copperheadhq/copperhead-555-oscillator/docs/DECISIONS.md

- 2026-11-10 [run 2026-11-10T13-39-13-392Z] SPEC sets VBUS range 4.75–5.25 V, a timing-cap tolerance of ≤5 %, ~10 % endpoint margin on the frequency range, high-Z load ≥1 kΩ‖≤150 pF, and R_A ≥ 1 kΩ (all ASSUMED). | why: The brief is silent on these values. They are the standard USB 2.0 and 555 practice that keep the 30 mA budget and the 10 kHz–1 MHz range achievable. | affects: docs/SPEC.md; timing network; ESD; output
- 2026-11-10 [run 2026-11-10T13-39-13-392Z] No openspec/specs/ seeded | why: No openspec/ capability workspace exists (only the change folder created by this proposal), so the stage instruction to seed it does not apply. | affects: openspec/
- 2026-11-10 [run 2026-11-10T13-39-13-392Z] Keep TPD1E10B06DYAR on VBUS, and document that its ≤10 V clamp exceeds the SN74LVC1G17's 6.5 V abs-max | why: Bench USB supply has ESD exposure only. The local 100 nF and 10 µF capacitors absorb the residual energy. Flagged in SPEC §8 for the schematic stage rather than silently claimed safe. | affects: VBUS ESD diode; U2 SN74LVC1G17; docs/SPEC.md
- 2026-11-10 [run 2026-11-10T13-41-05-012Z] Register R_A >= 1 kOhm as constraint timing.ra_min_ohm (ASSUMED) | why: SPEC §2 stated it as a budget, but no registry entry existed. A minimum R_A bounds the timing-network current at 1 MHz within the 30 mA supply budget. | affects: timing network R_A; docs/SPEC.md §2; .copperhead/constraints.json
- 2026-11-10 [run 2026-11-10T13-41-58-945Z] Patch docs/SPEC.md in place and do not rewrite it. Add registry keys timing.trimmer (100 kΩ 25-turn), timing.cap_nF (1 nF), board.mounting_holes (2× M3) and build.quantity (about 5). Seed openspec/specs/{power,oscillator,output,physical}/spec.md with Given/When/Then scenarios. | why: The existing SPEC already held every other budget. These four stated values had no registry key, and an openspec/ workspace now exists, so the capability specs apply. | affects: docs/SPEC.md §3 and §5; .copperhead/constraints.json; openspec/specs/
- 2026-11-10 [run 2026-11-10T16-25-05-768Z] Timing network: R_A = 1.00 kΩ 1 %, R_B = 120 Ω 1 % fixed in series with a 100 kΩ 3296W rheostat, C = 1 nF C0G. The ideal range is 7.2 kHz to 1.16 MHz. | why: R_A sits at the timing.ra_min_ohm floor to maximise f_max. The fixed R_B keeps a defined low phase at the trimmer end stop. The low end meets the ≤9 kHz margin across the trimmer's ±10 %. The top end margin is thin and is tracked as timing.trimmer_end_resistance_ohm. | affects: R3, R4, RV1, C4, U1; docs/SUBSYSTEMS.md
- 2026-11-10 [run 2026-11-10T16-25-05-768Z] Activity LED D3 is driven from BUF_OUT (U2 output, before the 33 Ω R5) through 2.0 kΩ. The power LED D2 is on +5V through 2.0 kΩ. | why: This keeps the LED two stages away from the timing node (timing.node_loading) and off U1's output. The ≈1.5 mA per LED keeps the total near 9.6 mA, against 30 mA. | affects: D2, D3, R6, R7, U2; nets BUF_OUT, +5V
- 2026-11-10 [run 2026-11-10T16-25-05-768Z] No MCU, no connectivity subsystem, no regulator, no battery and no range switch. USB D+ and D− carry no-connect flags. | why: The brief is a purely analog 555 oscillator powered from USB only, and power.regulator forbids a regulator or battery. Stating the absence prevents it from being read as an omission. | affects: docs/SUBSYSTEMS.md; J1
- 2026-11-10 [run 2026-11-10T16-30-05-732Z] Two timing ranges: C4 3.3 nF C0G (LO) and C6 330 pF C0G (HI), both ±5 %. R3 1.00 kΩ, R4 120 Ω and RV1 3296W 100 kΩ are kept. Worst case: LO 2.54–120.6 kHz, HI 25.4 kHz–1.206 MHz, overlap 4.7:1. | why: The worst-case R span per range is 52.5:1 with 1 % end resistance (47.5:1 after C tolerance). A 10:1 capacitor step gives about 5:1 overlap and ≥ 20 % top margin for the TLC555 delays. | affects: C4, C6, R3, R4, RV1; docs/SPEC.md §3; docs/SUBSYSTEMS.md
- 2026-11-10 [run 2026-11-10T16-30-05-732Z] SW1 is an SPDT top-side slide switch with its common on GND and its throws on the ground ends of C4/C6, so it switches the capacitor's ground return and not the TIMING node. | why: This keeps switch contacts and their trace length off the timing node (timing.node_loading). The unselected capacitor adds only about the switch off-capacitance, a few pF. | affects: SW1, C4, C6, net TIMING
- 2026-11-10 [run 2026-11-10T16-30-05-732Z] The silkscreen range labels are 'LO 10–100 kHz' and 'HI 100 kHz–1 MHz'. The current-budget upper bound is now ≈ 14.7 mA. | why: Each label lies inside its position's worst-case range. The current rises because the ideal HI end stop is up to ≈ 3.6 MHz, which raises the capacitor-charging and buffer C·V·f terms. That is still under 30 mA. | affects: docs/SPEC.md §2, §5; docs/SUBSYSTEMS.md current budget, Mechanical
- 2026-11-10 [run 2026-11-10T16-36-35-457Z] J2 BNC is the Amphenol RF B6252HB-NPP3G-50 right-angle THT, substituted for 31-5536-RFX. | why: No 31-5536 footprint is installed. The installed 031-6575 footprint has pads 3 and 4 with no pin on any installed coax symbol. The B6252HB keeps the brief's right-angle, board-edge, through-hole intent and maps 1:1 onto Connector:Conn_Coaxial. The connector's 50 Ω rating is not a drive claim (output.load). | affects: J2; docs/parts.intent.json substitutions; docs/SUBSYSTEMS.md; docs/SPEC.md §1, §8
- 2026-11-10 [run 2026-11-10T16-36-35-457Z] SW1 range switch is the C&K JS102011SAQN, a top-actuated SPDT SMD slide switch. | why: It meets timing.range_switch (top side, SPDT) and env.temperature_C (−40 to +85 °C). It carries only capacitor return current, well inside its 300 mA at 6 VDC rating. Its symbol (Switch:SW_SPDT) and footprint are installed. | affects: SW1; docs/SUBSYSTEMS.md Timer core; docs/SPEC.md §8
- 2026-11-10 [run 2026-11-10T16-36-35-457Z] Passive part choices:
- C4 GRM1885C1H332JA01D and C6 GRM1885C1H331JA01D, both C0G ±5 %.
- Yageo RC0603FR 1 % resistors.
- Samsung X7R for bypass and X5R for the 10 µF bulk.
- Würth 150060GS75000 green 0603 LEDs, 2.0 kΩ.
- D1 TPD1E10B06DYAR drawn as Device:D_TVS on SOD-523. | why: These meet timing.cap_dielectric, timing.resistor_tolerance_pct and env.temperature_C. Quiescent and leakage currents are U1 ≈ 170 µA, U2 ≤ 10 µA and D1 ≤ 1 µA, so the ≈ 14.7 mA bound against 30 mA is unchanged. TPD1E10B06 has no library symbol, and as a bidirectional single diode the generic TVS symbol is exact. | affects: C1–C6, R1–R7, D1–D3; docs/BOM.md
- 2026-11-10 [run 2026-11-10T16-39-40-062Z] SW1 (Switch:SW_SPDT) wiring: pin 2 (B, common) to GND, pin 1 (A) to CAP_LO (C4.2), pin 3 (C) to CAP_HI (C6.2). | why: This puts the switch in the capacitor ground return, so no switch contact sits on TIMING (timing.range_switch, timing.node_loading). | affects: SW1, C4, C6; nets CAP_LO, CAP_HI, GND; docs/PINOUT.md
- 2026-11-10 [run 2026-11-10T16-39-40-062Z] RV1 is wired as a rheostat: pin 1 and wiper pin 2 on RB_TRIM (from R4), pin 3 on TIMING. | why: A shorted wiper means a wiper lift-off cannot open-circuit R_B. The range then falls back to the full track, not an uncontrolled state. | affects: RV1, R4; nets RB_TRIM, TIMING
- 2026-11-10 [run 2026-11-10T16-39-40-062Z] J1's shell (SH) is tied directly to GND, and U1 ~RST is tied to +5V. | why: This is a bench board with no enclosure and no shield drain to manage. Tying ~RST high keeps the timer always running, per SUBSYSTEMS. | affects: J1, U1; nets GND, +5V
- 2026-11-10 [run 2026-11-10T16-39-40-062Z] Accept the verify_symbols 'wrong-library' findings for the power symbols that draft_schematic synthesizes (copperhead_power:+5V/GND/PWR_FLAG). Do not patch the sheet. | why: The engine generates these symbols, and edit_file is refused on the drafted sheet. Pins and names match power:*, and ERC is clean. They are flagged in CHANGELOG so that a later engine fix can remap them to power:*. | affects: 5-v-variable-frequency-555-oscillator.kicad_sch power symbols
- 2026-11-10 [run 2026-11-10T16-41-22-515Z] Layout draft: 60 × 35 mm outline, J1 on the left edge and J2 BNC on the right edge (both rotated 270°), U1 centred with the timing cluster (C4, C6, R3, R4, RV1, TP3) on its left and SW1 above C4/C6. TIMING is routed as one ≈ 8 mm F.Cu lane at y = 117.365, on the side away from U2 and the outputs. | why: This follows the signal flow J1 → U1 → U2 → J2, keeps TIMING short and away from BUF_OUT/OUT (timing.node_loading), and keeps SW1 only in the capacitor ground return (timing.range_switch). | affects: all footprints; nets TIMING, DIS, CAP_LO, CAP_HI, +5V; docs/LAYOUT.md
- 2026-11-10 [run 2026-11-10T16-41-22-515Z] Leave GND (no pour yet), most of +5V and the signal nets RAW, BUF_OUT, OUT, CONT, CC1, CC2, RB_TRIM and the LED nets as ratsnest: 46 connections, down from 56. The 4 J1 hole_clearance DRC findings are accepted as library-footprint geometry. | why: The stage asks for power and the short critical nets only. The finding is inside the GCT USB4105 footprint and cannot be fixed without editing the footprint, which the stage gate forbids. Both are listed in docs/LAYOUT.md Draft quality for follow-up. | affects: 5-v-variable-frequency-555-oscillator.kicad_pcb; J1; docs/LAYOUT.md
- 2026-11-10 [run 2026-11-10T17-27-11-140Z] Route the TIMING tie U1.6 → U1.2 as one straight F.Cu segment under U1 (≈ 5.1 mm). Keep the F.Cu GND pour off TIMING with a copperpour-only rule area over the lane, the tie and the TP3 stub. The B.Cu plane stays solid under it. | why: This is the shortest TIMING path. The pour keepout avoids adding top-layer capacitance to TIMING (timing.node_loading), while the B.Cu plane gives the continuous ground required by SPEC §5. | affects: net TIMING; U1; zones TIMING_F_pour_keepout, GND_F_pour, GND_B_plane
- 2026-11-10 [run 2026-11-10T17-27-11-140Z] GND is connected by explicit tracks: an F.Cu stub and via at every SMD GND pad, onto a B.Cu track network (spine x = 102.5, buses y = 103 and y = 129.8, riser x = 152.08). This is in addition to the full-board B.Cu and F.Cu GND zones. All +5V and signal copper is on F.Cu. | why: kicad-cli DRC here does not refill zones, so connectivity must not depend on the pour. Keeping all non-GND copper off B.Cu leaves the plane uncut under the oscillator and the output path. | affects: net GND, +5V; B.Cu; docs/LAYOUT.md
- 2026-11-10 [run 2026-11-10T17-27-11-140Z] Keep the 15 pure stitching vias even though DRC reports them as via_dangling warnings while the F.Cu zone is unfilled. Require Fill All Zones in KiCad before any fab export. | why: The person asked for stitching vias. The warnings come from the unfilled zone, not from the geometry, and they are warnings, not errors. Removing the vias to silence DRC would drop a requested feature, and unfilled zones would ship gerbers without any pour. | affects: GND stitching vias; docs/LAYOUT.md Draft quality
- 2026-11-10 [run 2026-11-10T17-27-11-140Z] Supersedes the earlier 'keep the 15 stitching vias' decision. Removed the 16 pure perimeter stitching vias and their B.Cu drops. Inter-layer GND stitching for now comes from the 13 GND pad vias. Perimeter stitching is deferred to a KiCad session after Fill All Zones. | why: With the F.Cu pour unfilled in the saved file (no tool here can fill zones), the perimeter vias had no F.Cu copper and failed DRC. The pad vias already join both layers across the board, and stitching placed against a filled pour can be verified by DRC. | affects: net GND stitching vias; docs/LAYOUT.md Draft quality; docs/CHANGELOG.md
- 2026-11-10 [run 2026-11-10T18-09-56-579Z] Set J1 (USB4105) GND pads A1, A12, B1, B12 to solid zone connection (zone_connect 2) on the board instance; the library footprint is unchanged. | why: With zones filled, DRC (--refill-zones) reported starved_thermal on these four pads against GND_F_pour: the fine pitch leaves too few thermal spokes. Solid connection is standard for USB-C GND pins and strengthens the SPEC §5 ground return. Reflow assembly by the fab is unaffected. | affects: J1 pads A1/A12/B1/B12; net GND; zones GND_F_pour, GND_B_plane; docs/LAYOUT.md
- 2026-11-10 [run 2026-11-10T18-15-04-031Z] SW1 silkscreen: 'LO 10–100 kHz' to the right of SW1 (pad 1, /CAP_LO, x ≈ 125.6) and 'HI 100 kHz–1 MHz' to the left (pad 3, CAP_HI, x ≈ 120.6). | why: The JS102011SAQN actuator connects common pad 2 to the terminal on its own side (C&K sheet I-52, research/parts/range-switch.md), so the slider position names the range. Confirm with a meter on the first board. | affects: SW1; silkscreen; timing.range_switch; docs/LAYOUT.md
- 2026-11-10 [run 2026-11-10T18-15-04-031Z] Label RV1 'CW = f ↑'. Label J2 'OUT (Hi-Z)', label J3's pins 'SIG' and 'GND' instead of 'OUT (Hi-Z)', and label TP5 'OUT'. No '50 Ω' text anywhere. | why: Clockwise moves the 3296 wiper toward pin 3 (TIMING), which lowers R_B and raises f. The person chose pin labels for J3 and OUT for TP5 (net OUT after R5, SPEC §4). Writing '50 Ω' is forbidden by output.load and SPEC §7. | affects: RV1, J2, J3, TP5; silkscreen; docs/SUBSYSTEMS.md; docs/LAYOUT.md
- 2026-11-10 [run 2026-11-10T19-29-22-474Z] Waive the 4 DRC hole_clearance findings inside J1 (GCT USB4105-GF-A): pads A1, A12, B1, B12 (GND) are 0.1944 mm from the footprint's own NPTH locating holes, against the 0.25 mm board rule. Keep the stock footprint unmodified. | why: Three grounds: (1) it is GCT's recommended land pattern in the stock KiCad footprint; (2) the copper is J1's own GND pads, so a drill nick cannot short anything; (3) JLCPCB's capabilities page (read 2026-11-10) gives a 0.2 mm NPTH-to-track minimum, so this is about 6 µm (5.6 µm) under. If fab DFM flags it, answer with this waiver. | affects: J1 pads A1/A12/B1/B12; net GND; DRC report; docs/LAYOUT.md Draft quality
- 2026-11-10 [run 2026-11-10T19-30-41-535Z] outputs/BOM.csv groups parts by MPN, with columns refdes, MPN and qty. It leaves out TP1–TP5 and H1–H2 (noPart: bare pads and holes) and carries no UNVERIFIED marker. The UNVERIFIED status stays in docs/BOM.md. | why: An ordering file should list only purchasable lines, and it is generated from docs/BOM.md so it cannot drift from it. MPN stock and lifecycle must still be checked before ordering (SPEC §8). | affects: outputs/BOM.csv; docs/BOM.md; all purchased parts
- 2026-11-10 [run 2026-11-10T19-32-24-380Z] Firmware stage: write firmware/README.md as '# No firmware'. Generate no HAL, pins.h or driver stubs. Flag explicitly that 74xGxx (U2 SN74LVC1G17) and copperhead_power (+5V/GND/PWR_FLAG) are outside the stage's non-programmable allowlist. | why: There is no MCU and no programming path (SPEC §1/§2, SUBSYSTEMS 'Not present'). U2 is fixed-function logic with no registers. copperhead_power is the engine's stand-in for power:*. Inventing source would describe hardware that does not exist. The allowlist gap belongs in the gate, not the design. | affects: firmware/README.md; U2; power symbols; docs/CHANGELOG.md
- 2026-11-10 [run 2026-11-10T19-34-17-558Z] Bring-up uses a 30 mA current limit on the 5 V supply, and range-end frequencies are measured at TP5/J2 with TP3 unprobed. The ngspice range-end check, BOM verification with LCSC numbers, and a CPL file are pre-order gates in docs/DEVPLAN.md. | why: 30 mA is the power.supply_current_mA budget, and the expected draw is ≤ 14.7 mA, so hitting the limit means a fault. A probe on TIMING shifts HI by ≈ 3–4.5 %. A JLCPCB PCBA order needs LCSC numbers and a CPL file, and outputs/ has neither. The HI top margin against TLC555 delays is unverified (SPEC §8). | affects: docs/DEVPLAN.md; outputs/jlcpcb-bom.csv; outputs CPL; TP3, TP5, J2
- 2026-11-10 [run 2026-11-10T19-36-24-548Z] State the existing registry key firmware.programmable_devices (max 0) in docs/SPEC.md §1 and on the MCU line of docs/SUBSYSTEMS.md 'Not present'. | why: The sync verifier flagged a dual-write gap: the key was in the registry but in no doc. Its source names these sections. The constraint itself is unchanged. | affects: docs/SPEC.md §1; docs/SUBSYSTEMS.md; firmware/README.md
- 2026-11-10 [run 2026-11-10T22-16-06-792Z] SW1 3D model is ${KIPRJMOD}/lib/ck_switches.3dshapes/SW-SMD_JS102011SAQN.step (EasyEDA, LCSC C221660), with offset (0, -0.475, 0.475) mm and rotation (0, 0, 0). Only the model block changed; there is no footprint, copper, placement or net change. | why: KiCad 10 does not ship SW_SPDT_CK_JS102011SAQN.step. The offset comes from the STEP coordinates:
- The locating pegs centre on model y = 0.475; moving them -0.475 puts them on the footprint NPTH at y = 0.
- The seating plane is at model z = -0.475; +0.475 puts it on the board surface.
- The terminals at x = -2.5/0/+2.5 land inside pads 1/2/3, spanning footprint y -1.75 to -3.7 within the pad's -1.5 to -4.0.
- The body spans ±1.75 against the Fab outline's ±1.8.
- The actuator ends at footprint y +3.75, on the courtyard-bulge side.
The EasyEDA model's +y equals the footprint's -y, so no rotation is needed. The check is numerical; no visual 3D render was inspected here. | affects: SW1 model; outputs/board.step; outputs renders; docs/LAYOUT.md
- 2026-11-10 [run 2026-11-10T22-18-55-021Z] Supersedes 'GND is connected by explicit tracks'. Removed the 24-segment B.Cu GND track network. GND connectivity is now the filled GND_B_plane and GND_F_pour zones plus the 13 pad vias and the F.Cu GND stubs. | why: The person asked for it after review. The tracks existed only because the zones could not be filled at routing time. With the zones filled (commit 23aaf9f) the tracks lay inside the plane and were redundant. DRC on the saved fill shows 0 unconnected and no via_dangling. The zone refill and save, and the --refill-zones DRC, could not be run with this toolchain and remain open before fab. | affects: net GND; B.Cu; zones GND_B_plane/GND_F_pour; J2/J3 GND pads; docs/LAYOUT.md; docs/DEVPLAN.md task 6
- 2026-11-10 [run 2026-11-10T22-27-46-251Z] Supersedes 'SW1 range switch is the C&K JS102011SAQN'. SW1 is the C&K JS102011SCQN (LCSC C221661), a top-slide SPDT SMD switch on the project footprint ck_switches:SW_SPDT_CK_JS102011SCQN (sheet I-53 pads). It stays at (123.1, 107), 180°, with nets unchanged. The CAP traces are extended to the new pads at y 104.5, and the GND stub and via are kept. | why: The brief and research/parts/range-switch.md require the slider to be moved from above (person's decision 2026-11-10). The old position leaves ≥ 3 mm of clear board around the body, with no tall part nearby. Keeping the rotation keeps pad 1 (LO) on the right, so the silkscreen sides are unchanged. | affects: SW1; nets /CAP_LO, CAP_HI, GND; fp-lib-table; docs/BOM.md; docs/LAYOUT.md; docs/SPEC.md §8; docs/SUBSYSTEMS.md
- 2026-11-10 [run 2026-11-10T22-27-46-251Z] SW1 3D model is SW-SMD_JS102011SCQN.step with offset (0, +1.475, +0.625) mm and rotation (0, 0, 0). The LO and HI labels move to y 104.5, level with pads 1 and 3. The saved GND_F_pour fill was hand-patched around the new pads. | why: The STEP body centre is at model y −1.475 and the lead bottoms are at z −0.625, so the offset centres the body and puts the leads inside pads 1/2/3 (checked numerically). Sheet I-53: the slider connects the common to the terminal on its own side, so the pad-1 end is LO. The fill patch was needed because no tool here can refill zones; a refill before fab is still required. | affects: SW1 model; silkscreen; zone GND_F_pour; docs/LAYOUT.md; docs/DEVPLAN.md task 6
- 2026-11-10 [run 2026-11-10T22-44-43-338Z] F.Cu routing rule: 45° chamfers at track bends and no acute angles; turns at pad centres are allowed. Applied to corners #4–#11, #13, #14 and #16, and to the +5V tee near R2. The collinear chamfer pairs on /CAP_LO and CAP_HI each become a single diagonal. The saved GND_F_pour fill was cut back by hand along the new diagonals. | why: The person asked for this (research/layout/right-angle-bends/right-angle-bends.pdf). Pad copper covers a corner at a pad centre, so those turns stay. The fill had to be patched because no tool here can refill zones and the old fill overlapped the diagonals. The cuts only remove copper, so they are conservative. A real refill with --refill-zones is still required before fab. | affects: nets +5V, /CAP_LO, CAP_HI, /CC2, /DIS, RB_TRIM; zone GND_F_pour; docs/LAYOUT.md; docs/DEVPLAN.md task 6
- 2026-11-11 [run 2026-11-11T06-33-49-150Z] Added 5 local GND stitching vias (0.6/0.3 mm) at (137.2,121), (140.3,120.5), (143.9,116.8), (143.9,120.4) and (122.8,124.3). These replace the perimeter-fence to-do; no fence is placed. No via went into the CAP_HI/CAP_LO strip, which already has the SW1 via at its root and runs beside TIMING. | why: The vias give the output edges (U2 → R5 → J2/J3) a short layer-to-layer return. They also ground the three F.Cu pour fingers or pockets that joined at one end only and had no via, per the person's request and SPEC §5. Keeping away from TIMING protects timing.node_loading. Each via sits in saved fill on both layers, so DRC shows no via_dangling without a refill. The refill itself stays DEVPLAN task 6. | affects: net GND; zones GND_F_pour, GND_B_plane; U2, R5, R7, J2, J3, RV1 area; docs/LAYOUT.md; docs/DEVPLAN.md tasks 6–7, risk 10
- 2026-11-11 [run 2026-11-11T06-40-42-448Z] Supersedes the 'one straight F.Cu segment' part of the TIMING-tie decision. U1.6 → U1.2 is now straight (126.525, 117.365)–(128.365, 117.365), then 45° to (129.635, 118.635), then straight to (131.475, 118.635). All three are 0.25 mm F.Cu on TIMING, inside the unchanged TIMING_F_pour_keepout. | why: The person asked for it (2026-11-11) so the tie follows the F.Cu 45° bend rule. The extra ≈ 0.36 mm adds negligible capacitance to TIMING (timing.node_loading). The path clears U1.7/U1.3 by ≈ 0.85 mm, and DRC is clean. The zone refill cannot be run here and stays DEVPLAN task 6. | affects: net TIMING; U1 pins 2/6; zone TIMING_F_pour_keepout; docs/LAYOUT.md; docs/DEVPLAN.md task 6
- 2026-11-11 [run 2026-11-11T06-45-37-422Z] The saved GND fill from commit c6fb79e (kicad-cli pcb drc --refill-zones --save-board, 2026-11-11) is the current fill of record. It supersedes the hand-patched fills from remove-bcu-gnd-track-network, sw1-top-actuated-js102011scqn and fcu-chamfer-bends-5v-tee, and the 'refill before fab' caveats in the earlier decisions. DEVPLAN task 6 is done, and risk 9 and the task 7 via_dangling check are closed. outputs/ was re-exported from this board, and task 8 is marked done only for those files. | why: The refill moved no object, and on the saved fill DRC gives 0 unconnected, only the 4 waived J1 hole_clearance findings, no starved_thermal and no via_dangling. run_drc in this run confirms 0 unconnected and the 4 waived findings. jlcpcb-bom.csv and the CPL file do not exist yet, so they stay with tasks 2 and 3. | affects: zones GND_F_pour, GND_B_plane; J1, J2, J3 GND pads; 5 stitching vias; outputs/*; docs/DEVPLAN.md tasks 6–8, risk 9; docs/LAYOUT.md
- 2026-11-11 [run 2026-11-11T06-48-37-150Z] Move the F.SilkS Reference fields of J1, SW1, TP3, C6, C4, C3, R4, R3 and J2, and the 'probe shifts f' and 'TIMING' board texts, to the person's verified positions. TP3's refdes is right-justified left of its pad. C4/C6 go above their parts, R3/R4 go below theirs (vertical), and J2's goes inside its body outline. | why: A glyph-outline analysis found labels ≤ 0.15 mm from pad mask openings or touching each other, which a fab may clip and which makes refdes ambiguous during hand assembly. The person's scratch-copy check shows ≥ 0.15 mm everywhere and DRC unchanged. No copper or placement moved. | affects: J1, SW1, TP3, C3, C4, C6, R3, R4, J2 silkscreen; gr_text 'TIMING', 'probe shifts f'; docs/LAYOUT.md Silkscreen labels
- 2026-11-11 [run 2026-11-11T06-55-02-278Z] F.SilkS board text 'probe shifts f' at (118.4, 110.6) now reads 'probe shifts freq'. Anchor, right justification, 0.8 mm size and 0.15 mm stroke are unchanged, so the text grows about 2 mm to the left. | why: 'f' is cryptic at the bench. The label warns that a probe on TP3 shifts the oscillator frequency (timing.node_loading; DEVPLAN TP3 row). It stays on its own baseline above 'TIMING', with the same gap, in a band (y ≈ 110.2–111.0) that holds no pad, refdes or other label: D1, R1 and the J1 pads are at y ≥ 112.6. DRC shows no silkscreen finding. Person's request, 2026-11-11. | affects: gr_text 'probe shifts freq'; TP3; docs/LAYOUT.md, docs/BOM.md (via parts.intent.json), docs/PINOUT.md, docs/DEVPLAN.md, docs/SUBSYSTEMS.md
- 2026-11-11 [run 2026-11-11T06-54-09-369Z] J2 (B6252HB BNC) GND pads (all three pad "2": two 3.5 × 7.0 mm lugs, one 1.6 × 2.5 mm pin) get a board-instance pad override thermal_bridge_width 0.5 mm. Thermal relief is kept, the thermal gap stays 0.3 mm, the zones' own thermal_bridge_width stays 0.3 mm, and pad 1 (OUT) and the library footprint are untouched. | why: The BNC is the most-plugged connector, so wider spokes make its ground connection to both GND pours more robust (SPEC §5), while relief is kept for hand soldering (BRIEF). A pad-level override limits the change to J2. DRC (no refill) is clean. The refill and the --refill-zones check could not be run here and are DEVPLAN task 9. | affects: J2 pads 2; net GND; zones GND_F_pour, GND_B_plane; docs/LAYOUT.md; docs/DEVPLAN.md task 9; outputs/ gerbers
- 2026-11-11 [run 2026-11-11T10-48-21-889Z] The copperhead identity block is B.SilkS board graphics, all text (justify mirror). The mark (ring r 0.693 mm and four ticks to r 1.353 mm, 0.30 mm stroke, 3.0 mm across, SVG scaled 0.132) is at (141.5, 102.3). Beside it is the 1.0 mm `copperhead` wordmark at (135, 102.3), followed by 0.8 mm lines `555 variable oscillator` (136, 104.3), `5 V · 10 kHz–1 MHz · rev A` (136, 105.7) and `2026-11` (136, 107.1). | why: Per BRIEF Design constraints (2026-11-11). The strip x 127–146, y 100.8–107.6 has no back-side pad, via or hole, and is far from J1, J2, J3, RV1, H1 and H2. Mirroring puts the reader's left at board +x, so the mark sits at higher x than the wordmark. DRC shows no silkscreen findings. Front silk and copper are untouched. | affects: B.SilkS; docs/LAYOUT.md Bottom identity block; docs/DEVPLAN.md task 9 (re-export)
- 2026-11-11 [run 2026-11-11T11-17-15-630Z] Supersedes the B.SilkS identity-block decision. The copperhead identity block is on F.SilkS, not mirrored: mark at (121.5, 128.3), `copperhead` 1.0 mm left-justified at (123.6, 128.3), then `555 variable oscillator`, `5 V · 10 kHz–1 MHz · rev A` and `2026-11` at 0.8 mm centred on x 129, y 130.9 / 132.2 / 133.5. All 9 B.SilkS items were removed; B.SilkS is empty. | why: BRIEF Design constraints (person's decision 2026-11-11) and the area the person pointed at in the viewer. The strip below RV1/U1/TP4, between D2/R6 and D3/J3, holds no pad, test point, via or hole. The board's 0.8 mm silk text minimum (DRC text_height) rules out the 0.7 mm shrink, and 0.8 mm fits. DRC shows no silkscreen findings. | affects: F.SilkS, B.SilkS; docs/LAYOUT.md Front identity block; docs/DEVPLAN.md task 9 (re-export)
- 2026-11-11 [run 2026-11-11T15-50-11-246Z] Supersedes the centred-text and date parts of the F.SilkS identity-block decision. The '2026-11' line is deleted. '555 variable oscillator' is at (120.0, 130.7) and '5 V · 10 kHz–1 MHz · rev A' is at (120.0, 132.0), both left-justified at 0.8 mm / 0.15 mm. The mark (121.5, 128.3) and the wordmark (123.6, 128.3) are unchanged. | why: BRIEF Design constraints (person's decision 2026-11-11): no date, and lines left-aligned to the mark's left edge (left tick end 120.147 minus half its 0.3 mm stroke ≈ 120.0). Moving the lines up 0.2 mm spaces them evenly under the wordmark, 0.35 mm below the mark's lower tick, and 2.6 mm from the bottom edge. DRC shows no silkscreen or text_height findings. | affects: F.SilkS identity block; docs/LAYOUT.md Front identity block; docs/DEVPLAN.md task 9
- 2026-11-11 [run 2026-11-11T17-11-19-766Z] F.SilkS copperhead identity block translated rigidly by the full requested (+2.0, +1.0) mm: mark centre (123.5, 129.3), 'copperhead' (125.6, 129.3), '555 variable oscillator' (122.0, 131.7), '5 V · 10 kHz–1 MHz · rev A' (122.0, 133.0). Sizes, strokes, justification and left alignment unchanged; no offset reduction needed. | why: Person's review request ('a bit down and to the right'). The rating line's bottom is still ≈ 1.6 mm from the edge, and the block stays clear of J3, D3, H2, its label and the GND via at (138.7, 127). DRC shows no silk_over_copper, silk_overlap, silk_edge_clearance or text_height finding. | affects: F.SilkS identity block; docs/LAYOUT.md Front identity block; docs/DEVPLAN.md task 9 (re-export)
