copperheadhq/copperhead-555-oscillator/images/board-back.png

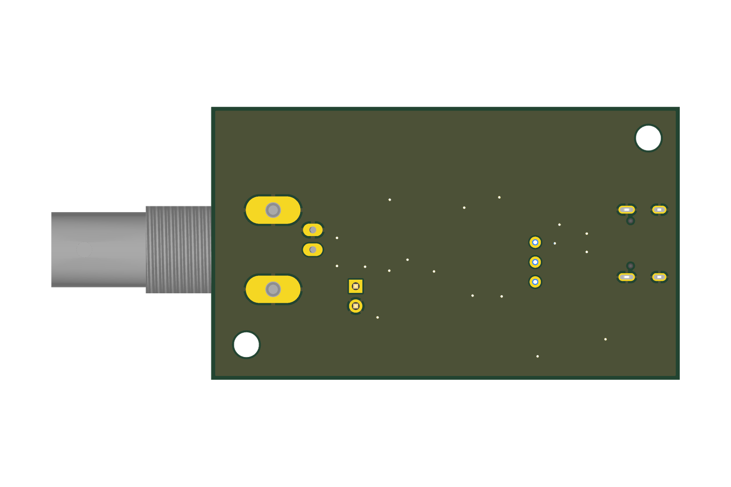
images/board-back.png
