copperheadhq/copperhead-555-oscillator/3d/555-oscillator-board-only.stl

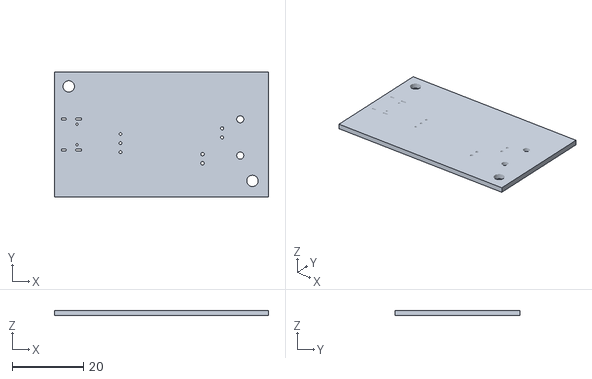
[picture p7: CAD file, 2026-11-11]
3d/555-oscillator-board-only.stl
60.0 x 35.0 x 1.51
