copperheadhq/copperhead-555-oscillator/3d/555-oscillator-mechanical.step

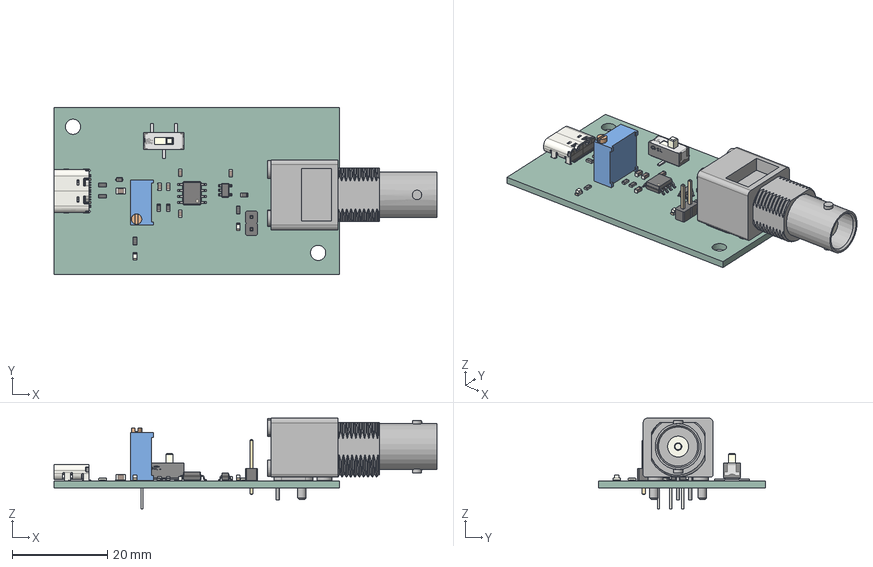
[picture p9: CAD file, 2026-11-11]
3d/555-oscillator-mechanical.step
80.5 x 35.0 x 19.1 mm
SW-SMD_JS102011SCQN
LED_0603_1608Metric x 2
PinHeader_1x02_P254mm_Vertical
C_0603_1608Metric x 5
BNC_Amphenol_B6252HB-NPP3G-50_Horizontal
R_0603_1608Metric x 7
USB_C_Receptacle_16P_TopMnt_Horizontal_GCT_USB4105-xx-A
C_0805_2012Metric
SOT-23-5
Potentiometer_Bourns_3296W_Vertical
D_SOD_523
SOIC-8_3.9x4.9mm_P1.27mm
5-v-variable-frequency-555-oscillator_PCB
