copperheadhq/copperhead-555-oscillator/(list of files, cad)

Other CAD files:
3d/555-oscillator.stl
