copperheadhq/copperhead-555-oscillator/docs/schematic.pdf

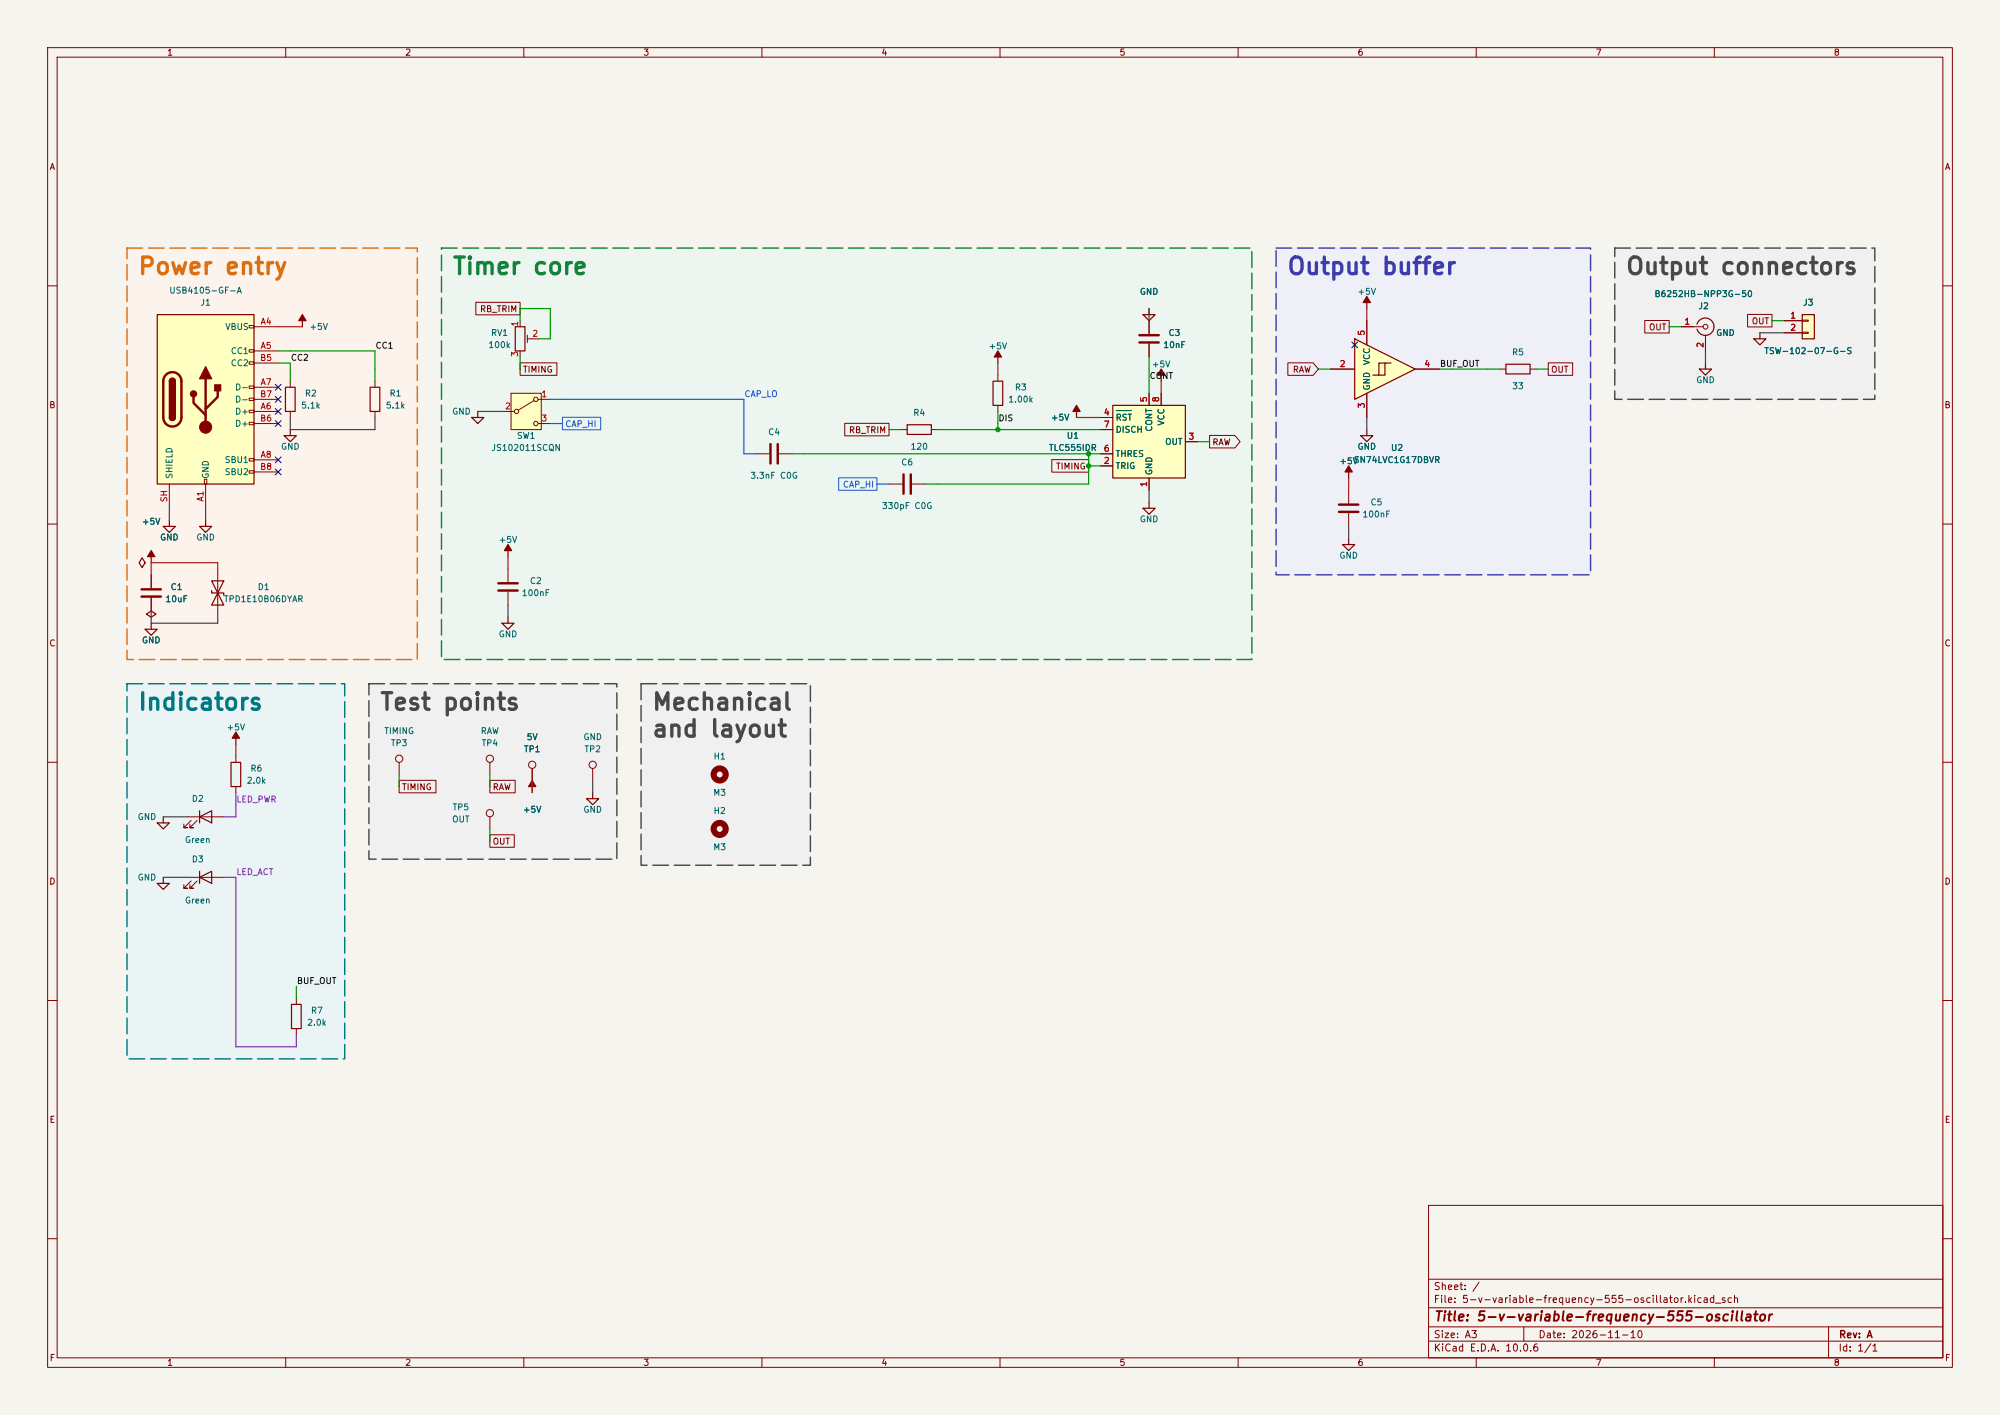
[picture p10: page 1]

Sheet: /
File: 5-v-variable-frequency-555-oscillator.kicad_sch
Title: 5-v-variable-frequency-555-oscillator

Size: A3 | Rev: A | F Date: 2026-11-10
KiCad E.D.A. 10.0.6 | Id: 1/1
