copperheadhq/copperhead-555-oscillator/hardware/5-v-variable-frequency-555-oscillator.kicad_pcb

## KiCad design hardware/5-v-variable-frequency-555-oscillator.kicad_pcb (2026-11-11)

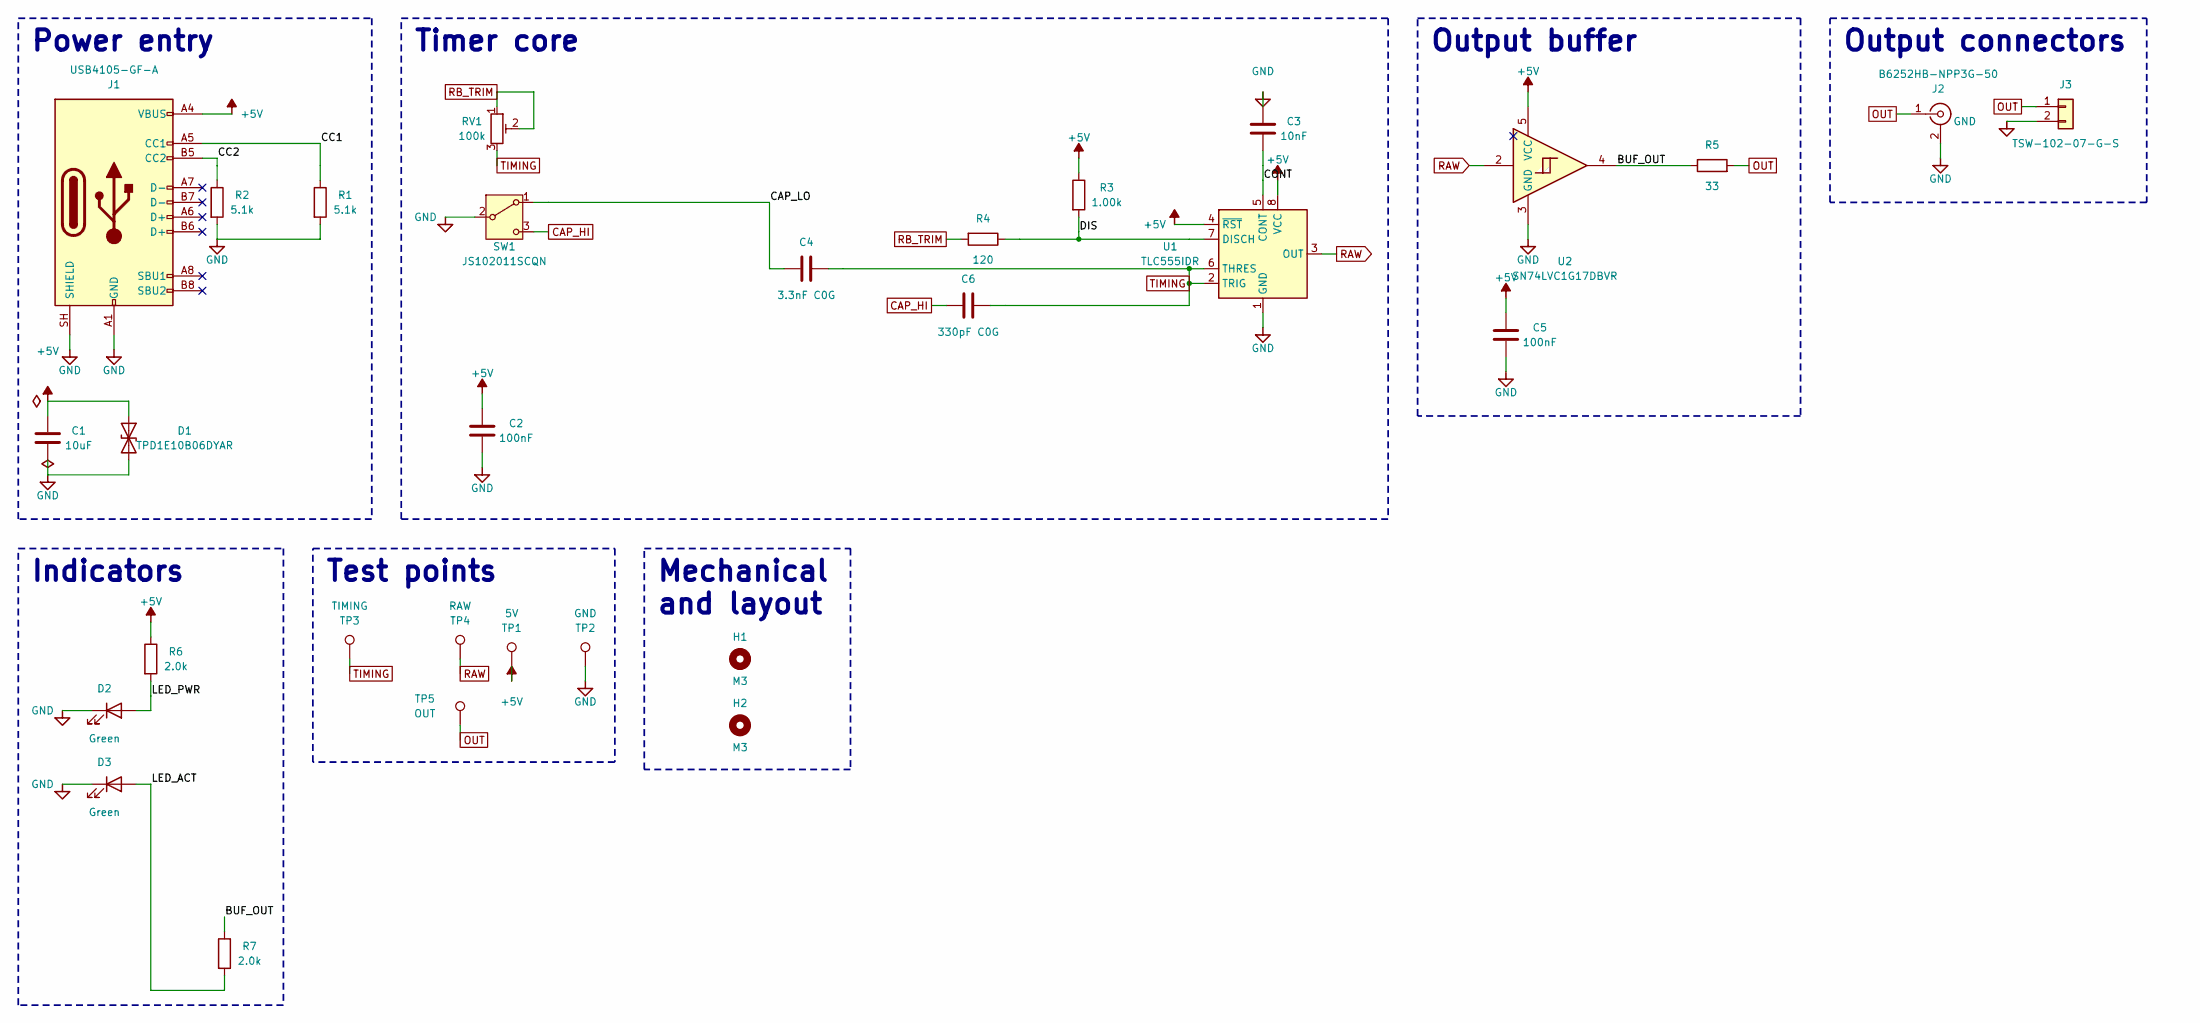
[picture p11: schematic 5-v-variable-frequency-555-oscillator.kicad_sch]

Parts:
C1: 10uF; C_0805_2012Metric
C2, C5: 100nF; C_0603_1608Metric
C3: 10nF; C_0603_1608Metric
C4: 3.3nF C0G; C_0603_1608Metric
C6: 330pF C0G; C_0603_1608Metric
D1: TPD1E10B06DYAR; D_SOD-523
D2, D3: Green; LED_0603_1608Metric
H1, H2: M3; MountingHole_3.2mm_M3
J1: USB4105-GF-A; USB_C_Receptacle_GCT_USB4105-xx-A_16P_TopMnt_Horizontal
J2: B6252HB-NPP3G-50; BNC_Amphenol_B6252HB-NPP3G-50_Horizontal
J3: TSW-102-07-G-S; PinHeader_1x02_P2.54mm_Vertical
R1, R2: 5.1k; R_0603_1608Metric
R3: 1.00k; R_0603_1608Metric
R4: 120; R_0603_1608Metric
R5: 33; R_0603_1608Metric
R6, R7: 2.0k; R_0603_1608Metric
RV1: 100k; Potentiometer_Bourns_3296W_Vertical
SW1: JS102011SCQN; SW_SPDT_CK_JS102011SCQN
TP1: 5V; TestPoint_Pad_D1.5mm
TP2: GND; TestPoint_Pad_D1.5mm
TP3: TIMING; TestPoint_Pad_D1.5mm
TP4: RAW; TestPoint_Pad_D1.5mm
TP5: OUT; TestPoint_Pad_D1.5mm
U1: TLC555IDR; SOIC-8_3.9x4.9mm_P1.27mm
U2: SN74LVC1G17DBVR; SOT-23-5

Connections:
+5V: C1.1, C2.1, C5.1, D1.1 (A1), J1.A4 (VBUS), J1.A9 (VBUS), J1.B4 (VBUS), J1.B9 (VBUS), R3.1, R6.1, TP1.1, U1.4 (~RST), U1.8 (VCC), U2.5 (VCC)
/BUF_OUT: R5.1, R7.1, U2.4
/CAP_LO: C4.2, SW1.1 (A)
/CC1: J1.A5 (CC1), R1.1
/CC2: J1.B5 (CC2), R2.1
/CONT: C3.1, U1.5 (CONT)
/DIS: R3.2, R4.1, U1.7 (DISCH)
/LED_ACT: D3.2 (A), R7.2
/LED_PWR: D2.2 (A), R6.2
CAP_HI: C6.2, SW1.3 (C)
GND: C1.2, C2.2, C3.2, C5.2, D1.2 (A2), D2.1 (K), D3.1 (K), J1.A1 (GND), J1.A12 (GND), J1.B1 (GND), J1.B12 (GND), J1.SH (SHIELD), J2.2 (Ext), J3.2, R1.2, R2.2, SW1.2 (B), TP2.1, U1.1 (GND), U2.3 (GND)
OUT: J2.1 (In), J3.1, R5.2, TP5.1
RAW: TP4.1, U1.3 (OUT), U2.2
RB_TRIM: R4.2, RV1.1, RV1.2
TIMING: C4.1, C6.1, RV1.3, TP3.1, U1.2 (TRIG), U1.6 (THRES)

Notes on the sheet:
Indicators
Mechanical and layout
Output buffer
Output connectors
Power entry
Test points
Timer core

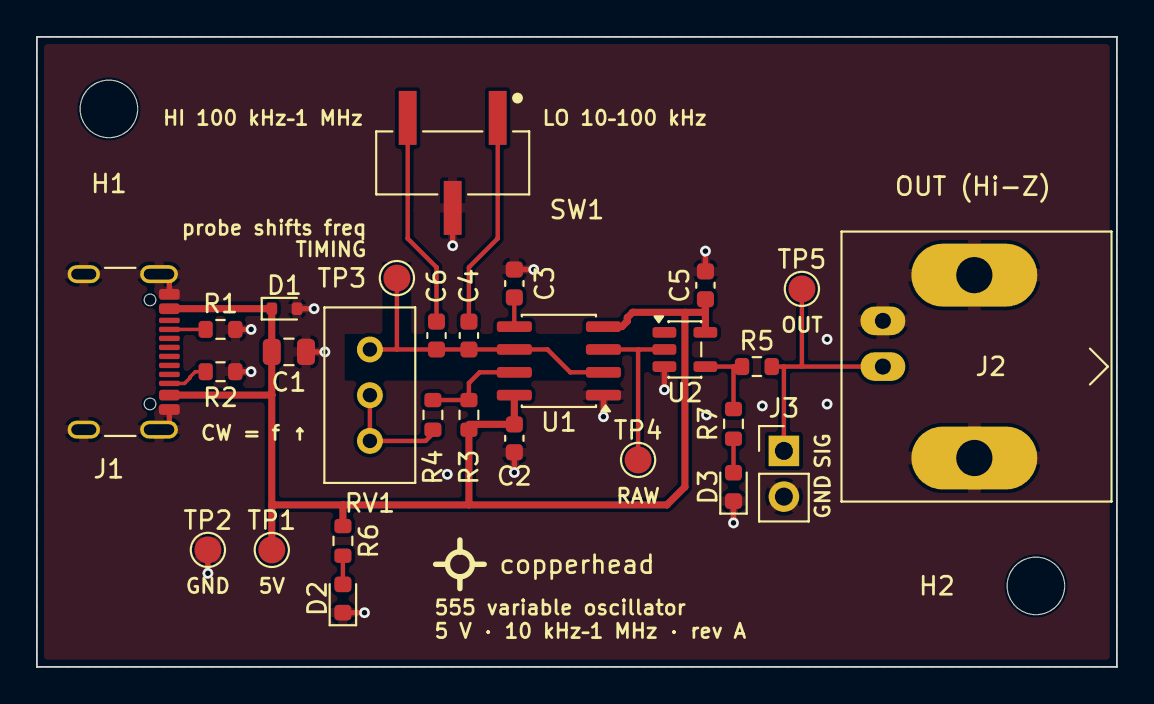
[picture p12: board 5-v-variable-frequency-555-oscillator.kicad_pcb from above]

Board: 2 copper layers, 60.0 x 35.0 mm, 30 parts (0 on the bottom side), 15 nets.
