copperheadhq/copperhead-555-oscillator/(commit log)

2026-11-11 Rev A: 5 V variable-frequency 555 oscillator
    Published from the copperhead design workspace at release commit c822784.
    [5-v-variable-frequency-555-oscillator-B_Cu.gbl, 5-v-variable-frequency-555-oscillator-B_Mask.gbs, 5-v-variable-frequency-555-oscillator-B_Paste.gbp, 5-v-variable-frequency-555-oscillator-B_Silkscreen.gbo, 5-v-variable-frequency-555-oscillator-Edge_Cuts.gm1, 5-v-variable-frequency-555-oscillator-F_Cu.gtl, 5-v-variable-frequency-555-oscillator-F_Mask.gts, 5-v-variable-frequency-555-oscillator-F_Pas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]
2026-11-11 images: re-render the board so the BNC and board edges are in frame
    The previous renders cropped J2's barrel and the board corners, and left
    grey floor-shadow blocks around the top and bottom views. Rendered larger
    with a transparent background, cropped to the board, and centred on white
    at 1512 x 1008, as in the other copperhead board repos.
